OpenApollo/OpenApolloV2/(list of files, drawings)

Other design files:
Circuit/PCB/PCB_OpenApolloV2.json
Circuit/Schematic/SCH_OpenApolloV2.json
Circuit/Schematic/SCH_OpenApolloV2_filesource.json
